ozw1z5rd/easypay/(list of files, drawings)

Other design files:
PCB_BACKUP/nuovo2.PCB
PCB_BACKUP/nuovo3.PCB
PCB_BACKUP/nuovo3_smallPADS.PCB
PCB_BACKUP/nuovo3_stampa e pezzi.PCB
PCB_BACKUP/nuovo.PCB
PCB_BACKUP/nuovo_bold.PCB
PCB_BACKUP/relay-def.pcb
PCB_BACKUP/TCONTRO4.PCB
PCB_BACKUP/TCONTRO41.PCB
PCB_BACKUP/TCONTRO412.PCB
PCB_BACKUP/TDISPLA2.PCB
PCB_BACKUP/tempi esposizione.pcb
PCB_BACKUP/TKEYB3.PCB
PCB_BACKUP/TRELE4.PCB
PCB_BACKUP/TRELE41.PCB
PCB_BACKUP/TRELE-def.PCB
PCB_BACKUP/unnamed.pcb
PCB_BACKUP/Versione corretta per le basette standard.PCB
